jang090623-alt/neo/manual_v2/REPORT.md

# 유성기어 시험기 조립 설명서 2차 — 확인 결과

## 결과물
| 파일 | 내용 |
|---|---|
| `manual.pdf` | 인쇄용 23쪽 (0 부품 전체, 1~21 단계, 22 그림 안내) |
| `pages/page00~22.png` | 쪽 이미지 1400×1000 |
| `bracket_in.stl` | 입력측 센서 받침 수정판 (닫힌 솔리드, 열린 모서리 0, 부피 2655.5 mm³) |
| `src/det.scad` | 수정한 3D 장면 (원본은 `src/det_v1_orig.scad`) |
| `src/compose_pages_v2.py` | 쪽 합성 코드 |
| `src/chk_brk.scad`, `chk2.scad`, `coll.scad`, `coll_b.scad` | 겹침 검사 장면 |

## 1. bracket 겹침 (OpenSCAD intersection → STL 부피 계산)
| 대상 | 겹침 부피 | 범위 |
|---|---|---|
| 원본 bracket ↔ plate_in (입력측) | **468.7 mm³** | x −9.0~−5.2, y −4.8~24.0, z 32.0~62.0 |
| bracket_in ↔ plate_in | **0** (결과 비어 있음) | 끝벽 안쪽 면과 0.2 mm 틈 그대로 |
| bracket_in ↔ ring | 0 | |
| bracket_in ↔ tray | 0 mm³ (윗면 z=32에서 면 접촉만) | |
| 출력측 bracket ↔ plate_out | 0 | |
| 출력측 bracket ↔ ring | 0 | |
| 출력측 bracket ↔ tray | 0 mm³ (면 접촉만) | |

## 2. 추가로 찾은 문제
| # | 내용 | 수치 | 처리 |
|---|---|---|---|
| A | 아래 볼트 2개 머리가 트레이 입력측 끝벽을 파고듦 | 131.5 mm³, x −12.0~−9.2 (2.8 mm) | 사용자가 해결함(방법 미확인). 그림은 설계 그대로 |
| B | det.scad의 bracket 위치 y=9에서는 바닥 긴 구멍이 끝벽 나사 구멍(y=+12)에 못 미침 | M3 나사 몸체와 8.7 mm³ 겹침 | 장면만 y=10으로 옮김 → 0 |
| C | det.scad의 자석이 원판 홈이 아닌 몸체 속에 있었음 | 168.6 mm³ (자석 2개 전체) | 원판을 돌려 홈 위치에 맞춤 → 0 |
| D | 홀센서~원판 간격이 1.75 mm (README는 2~3 mm) | | 2.5 mm로 둠 |
| E | 커플링 구멍 없음, 케이블타이가 받침을 관통, 홀센서 다리가 브래킷과 겹침 | 507 / 805.5 / 0.1 mm³ | 단순 모양을 고쳐 모두 0 |
| F | 모터 받침 나사가 위로 솟고 레일 구멍과 어긋남, 받침당 2개면 총 6개 (README 4개) | | README 수량대로 받침 1·브래킷 1, 실제 구멍(−80.2, 113.4 mm)에 |
| G | 커플링을 끼운 뒤에는 자석 원판(Ø6 구멍)을 막대에 끼울 수 없음 (README 9→10 순서도 같음) | | 원판 15단계 → 모터 16 → 커플링 17로 순서 변경 |

수정 후 완성 장면 13개 부품 그룹의 모든 짝(78쌍) 검사 결과: 위 A, 나사(Ø3)가 Ø2.5 구멍에 셀프태핑으로 들어가는 부분(15.9·23.8 mm³)만 남고 나머지는 0 또는 면 접촉입니다.

## 3. 쪽별 확인 (렌더링 이미지를 직접 열어 봄)
| 단계 | 확인한 것 | 결과 |
|---|---|---|
| 0 | 부품 수: README 목록과 대조, 색 규칙 | 맞음. 홀센서·온도센서는 README 구매 목록에 없어 하단에 적음 |
| 1 | 베어링 좁은 쪽이 아래, 화살표 아래, 돌기 면 위, 확대(플랜지-홈)·뒤집은 판 | 맞음 / README 1 |
| 2 | 1과 같음, plate_in | 맞음 / README 1 |
| 3 | 막대 끝 = 기어 면(단면), 화살표 아래 | 맞음 / README 2 |
| 4 | hub 육각이 위로 carrier에, 막대 끝 = 육각 끝면(단면), 화살표 위 | 맞음 / README 3 |
| 5 | 점 있는 면이 아래, 화살표가 기어 아래 빈 곳 | 맞음 / README 4 (1차는 화살표가 기어 속에서 시작 → 고침) |
| 6 | ring이 plate_out 위, 돌기-구멍 단면 | 맞음 / README 5 |
| 7 | carrier 판이 planet 아래, 막대가 베어링 쪽 | 맞음 / README 5 |
| 8 | sun 허브가 위, 짧은 막대 위 | 맞음 / README 6 |
| 9 | plate_in 안쪽 면 아래, 베어링이 판과 함께 | 맞음 / README 6 |
| 10 | 볼트 머리가 plate_in 쪽, 화살표 4개 | 맞음 / README 6 (속 기어가 빠져 있던 것 추가) |
| 11 | 뒤집힘(plate_out 위), 너트가 홈 속(단면) | 맞음 / README 6 (빠졌던 입력측 베어링 추가) |
| 12 | 두 회전 화살표가 같은 방향, 300°:75° = 4:1 | 맞음 / README 7 |
| 13 | 부채꼴 창 아래, 긴 막대가 빈 칸 쪽 | 맞음 / README 6·8 |
| 14 | 받침 2개, 나사 아래 방향 | 맞음 / README 9 |
| 15 | 원판이 막대 끝에서 들어옴, 자석 홈, 반대쪽 시점 | 맞음 / README 10 (순서 변경 G) |
| 16 | 모터 축이 기어 상자 쪽, 타이가 통로로(단면) | 맞음 / README 9 |
| 17 | 모터를 밀어 끼우는 화살표, 반대쪽 시점 | 맞음 / README 9 |
| 18 | 입력측 bracket_in, 간격 2.5 mm 표시, 반대쪽 시점 | 맞음 / README 10 (가려진 왼쪽 화살표 제거) |
| 19 | 센서 끝 z=6 < 오일면 z=17 | 맞음 / README 11 |
| 20 | 오일 15 mm, 긴 눈금(15 mm) 위치 | 맞음 / README 12 |
| 21 | 완성, 반대쪽 시점 | 맞음 |
| 22 | 단순화 부품 안내 | 적음 |
| 모든 쪽 | 글자 잘림 | 없음 (글자가 넓으면 자동으로 줄이고, 23쪽 모두 열어 확인) |

## 4. 확인하지 못한 것
- 실제 출력물 조립 전체 (끼움 정도, 기어 회전 저항, 오일 누수)
- 볼트 머리 문제(A)를 사용자가 해결한 방법. 설명서 10·13단계는 설계 그대로 그림
- bracket_in.stl의 실제 출력과 끝벽 고정
- 홀센서를 받침에 붙이는 방법 (설계에 없음)
- 모터·커플링·센서·케이블타이·주사기의 실제 모양 (단순화해 그림)
- 원판(Ø6 압입 구멍)을 막대 끝에서 끝벽 위까지 밀어 넣을 수 있는지 (압입이라 힘들 수 있음)
- 커플링을 끼운 뒤 모터를 밀 때, 케이블타이를 느슨하게 감은 상태로 충분히 밀리는지
