jang090623-alt/neo/report/figs/fig3_flow_time_v3.png

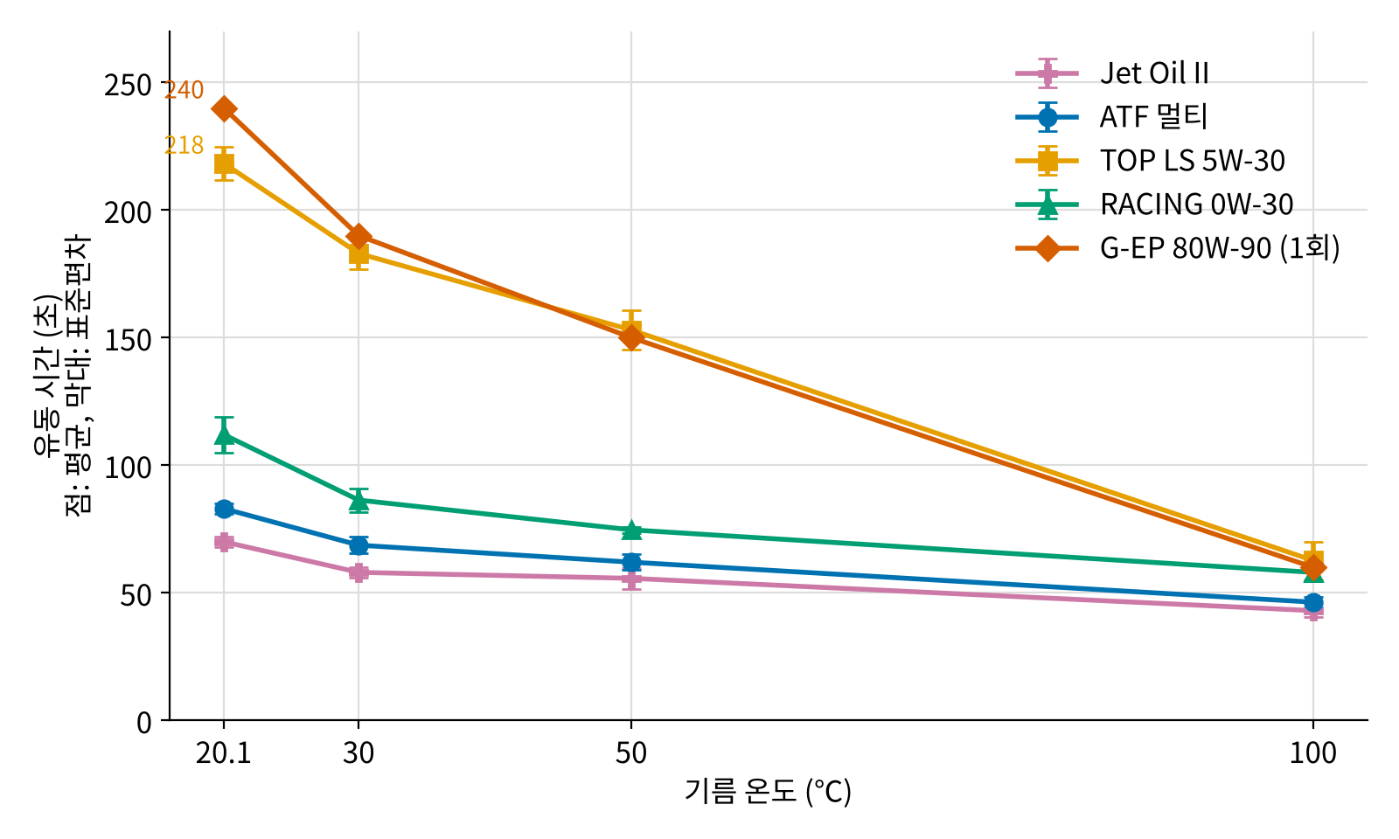
report/figs/fig3_flow_time_v3.png
