jang090623-alt/neo/report/figs/fig4_room_rpm.png

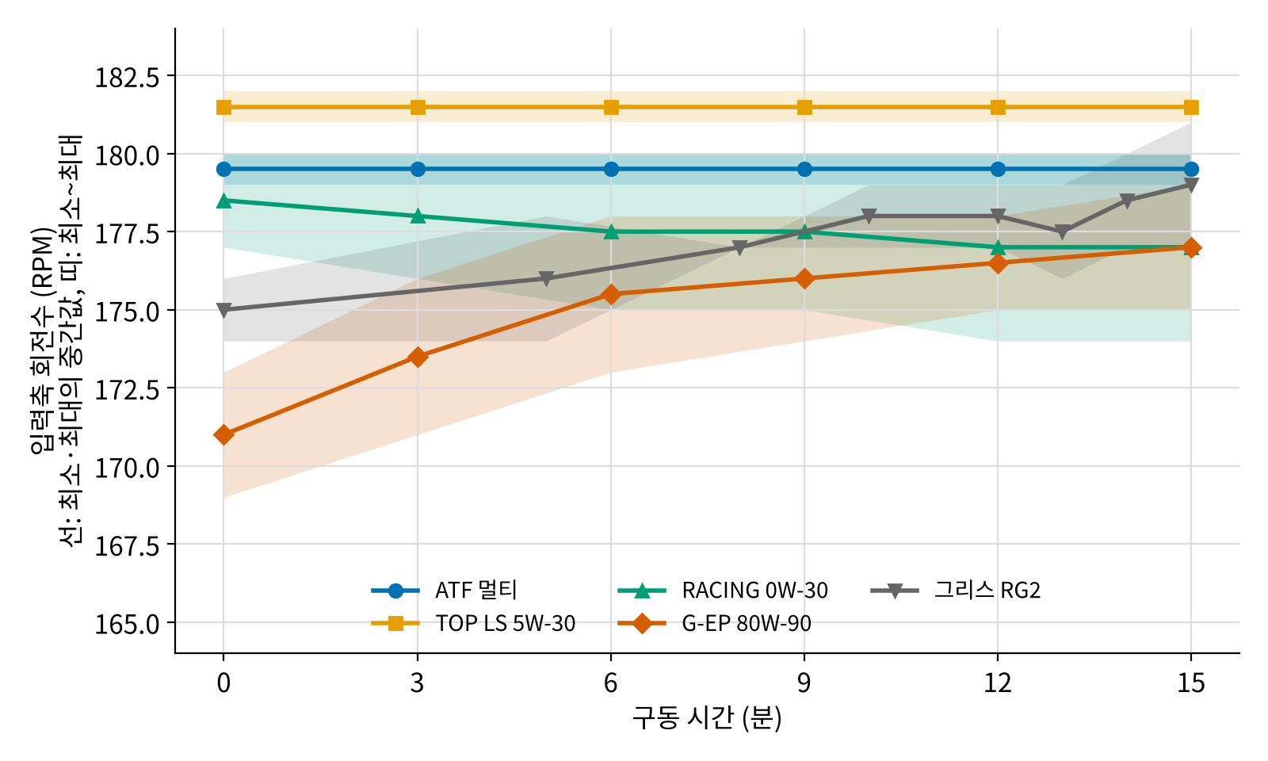
report/figs/fig4_room_rpm.png
