jang090623-alt/neo/report/figs/fig7_efficiency.png

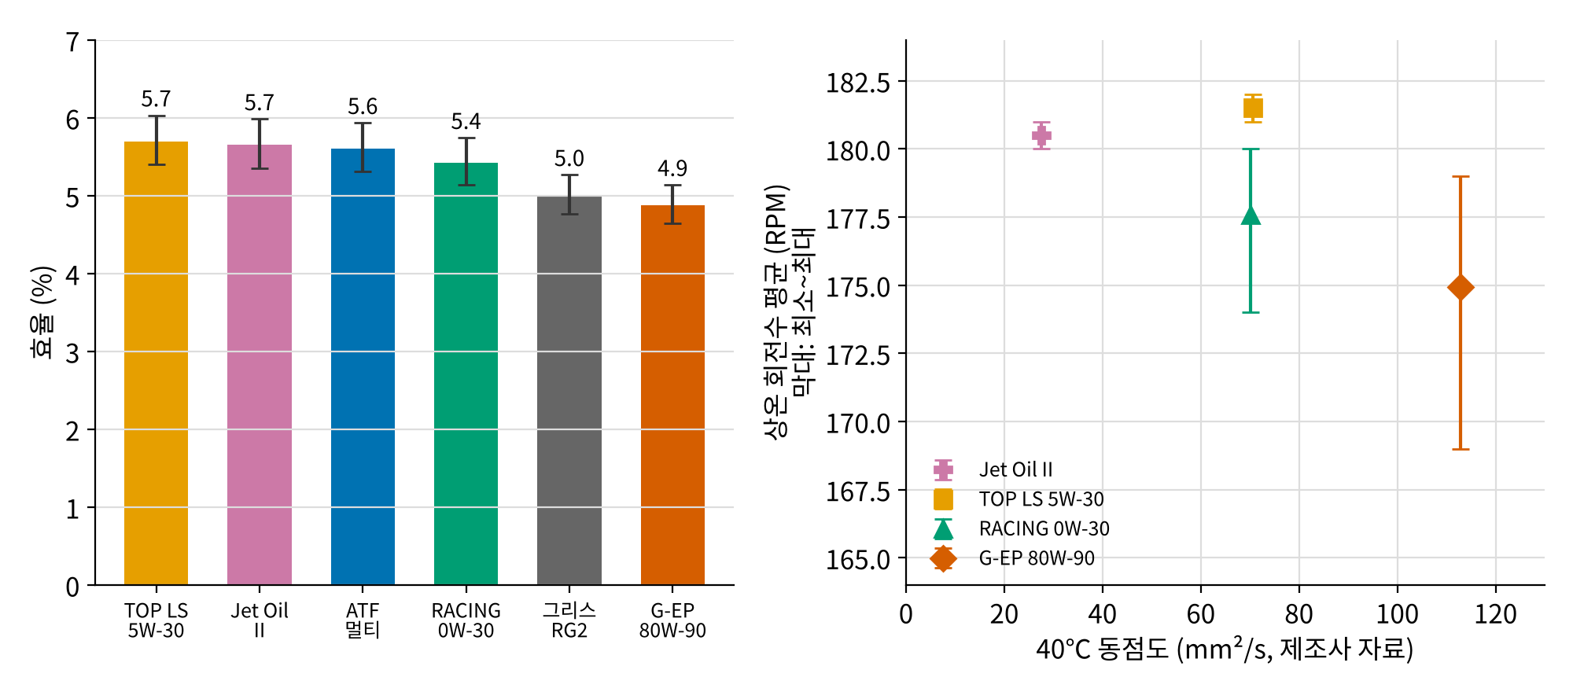
report/figs/fig7_efficiency.png
