jang090623-alt/neo/ball_on_disk/fit_guide.stl

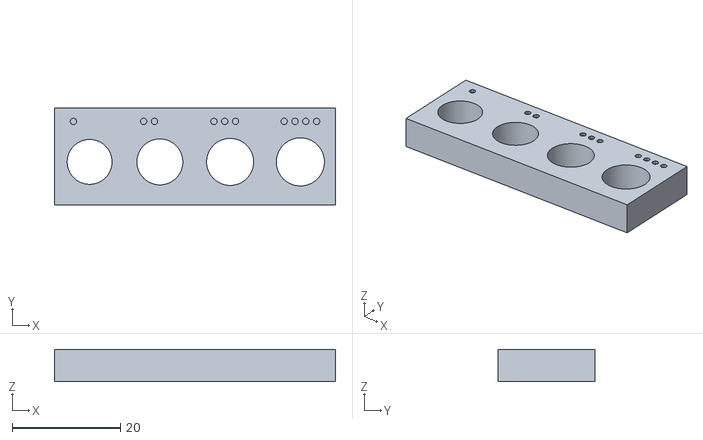
[picture p10: CAD file, 2026-11-05]
ball_on_disk/fit_guide.stl
52.0 x 18.0 x 6.00
