jang090623-alt/neo/ball_on_disk/orig/pin.stl

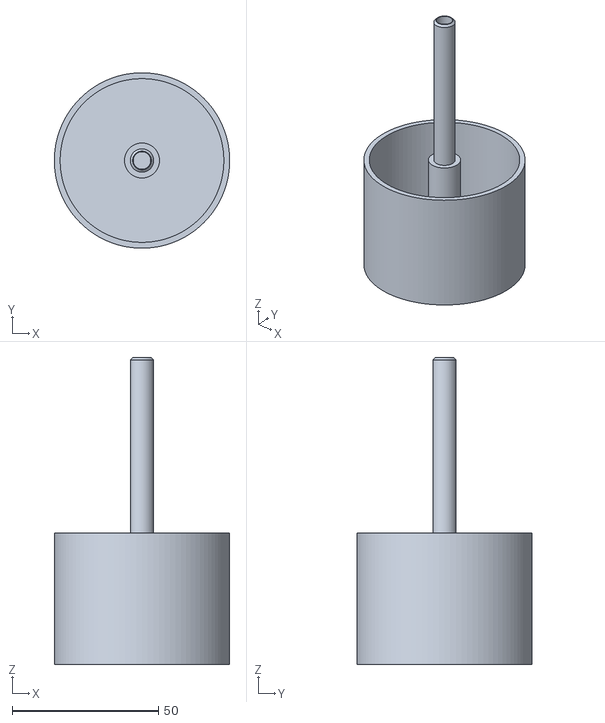
[picture p11: CAD file, 2026-11-05]
ball_on_disk/orig/pin.stl
60.0 x 60.0 x 105.0
