jang090623-alt/neo/manual_v2/bracket_in.stl

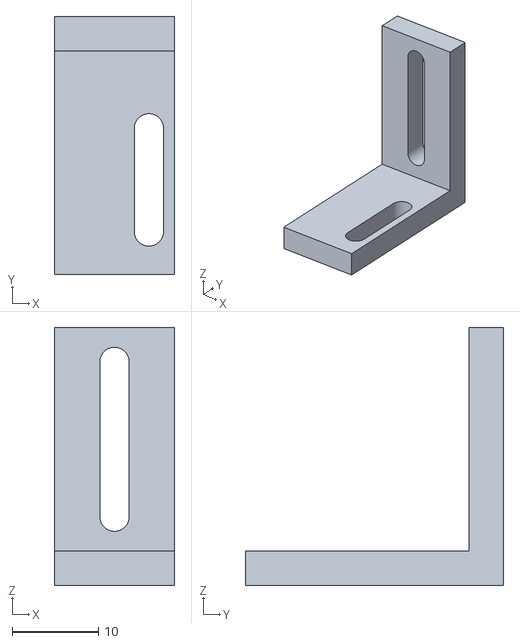
[picture p12: CAD file, 2026-11-05]
manual_v2/bracket_in.stl
14.0 x 30.0 x 30.0
