jang090623-alt/neo/ball_on_disk/orig/arm.stl

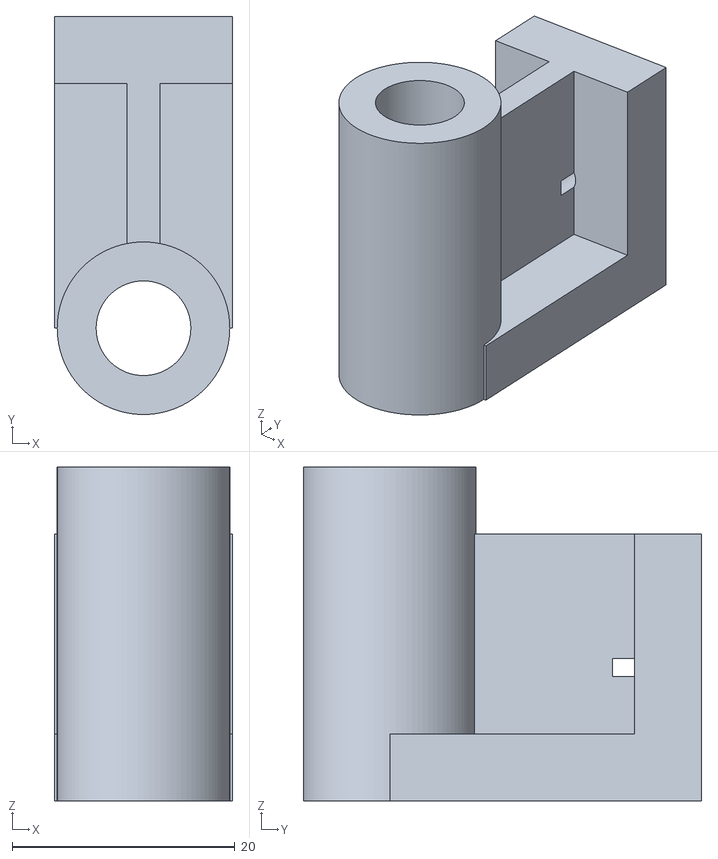
[picture p13: CAD file, 2026-11-05]
ball_on_disk/orig/arm.stl
16.0 x 35.8 x 30.0
