jang090623-alt/neo/ball_on_disk/orig/hub.stl

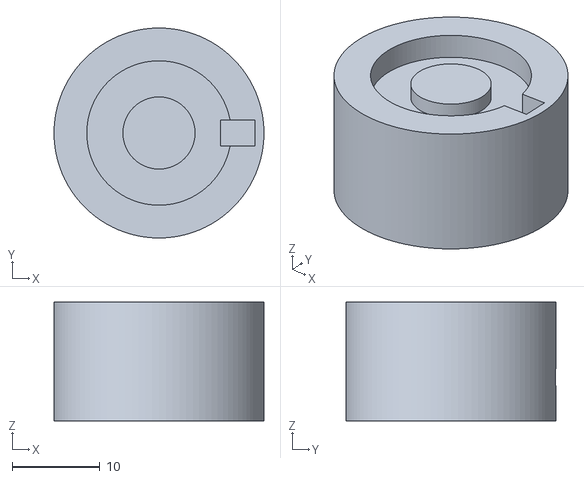
[picture p14: CAD file, 2026-11-05]
ball_on_disk/orig/hub.stl
24.0 x 24.0 x 13.6
