jang090623-alt/neo/manual_v2/src/exp_bi.scad

use <det.scad>
bracket_in();
