jang090623-alt/neo/(list of files, cad)

Other CAD files:
manual_v2/src/det_v1_orig.scad
