jang090623-alt/neo/manual_v2/pages/page00.png

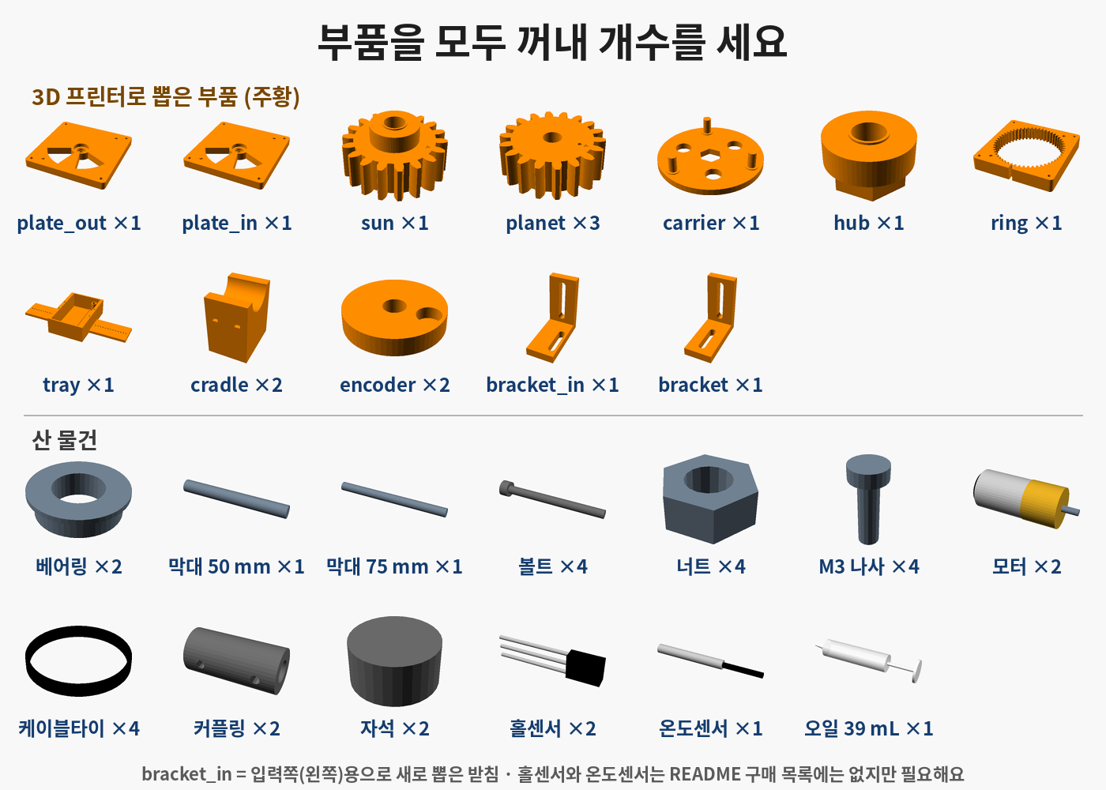
manual_v2/pages/page00.png
