jang090623-alt/neo/manual_v2/pages/page02.png

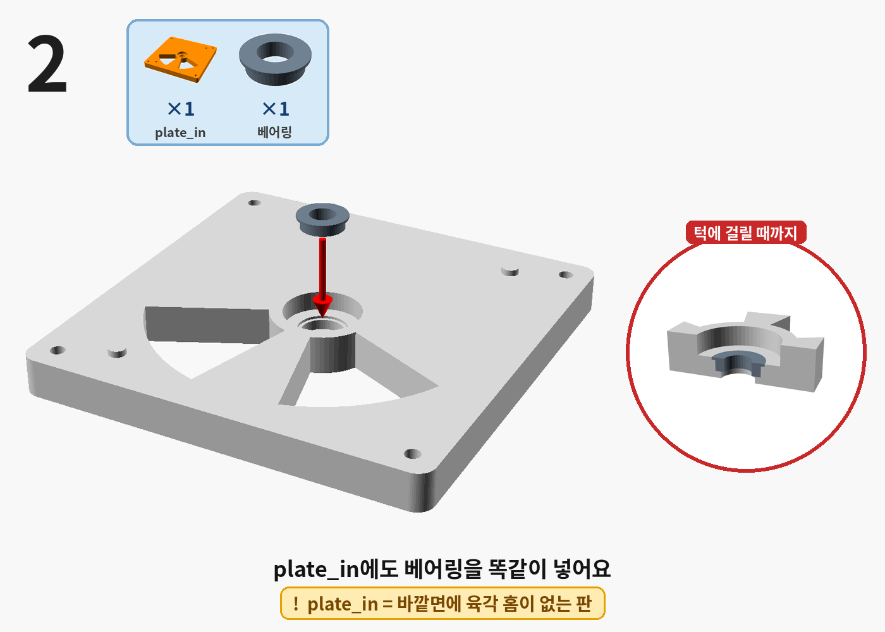
manual_v2/pages/page02.png
