jang090623-alt/neo/manual_v2/pages/page04.png

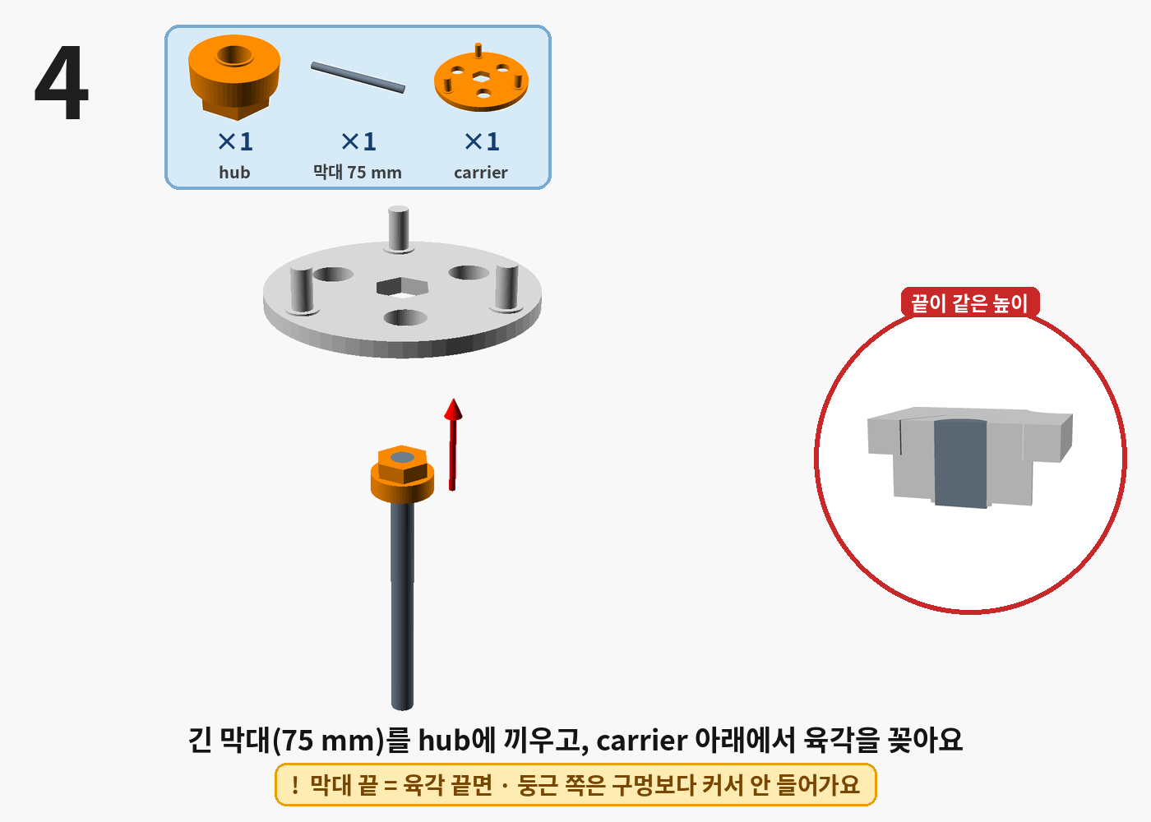
manual_v2/pages/page04.png
