jang090623-alt/neo/experiment/효율_기록시트.xlsx

Sheet: 설명
윤활유 비교 실험 기록 시트
■ 효율이란?
효율(%) = 나온 힘(출력 전력) ÷ 넣은 힘(입력 전력) × 100
입력 전력(W) = 전원 공급기 전압(V) × 전원 공급기 전류(A) ← 전원 공급기 화면에서 읽기
출력 전력(W) = 발전기 전압(V)² ÷ 부하 저항(Ω) ← 왼쪽 모터에 저항을 달고 멀티미터로 전압 재기
■ 방법 A (지금 상태: 왼쪽 모터 선 연결 안 함)
나오는 힘이 0이라 효율(%)은 계산 못 함. 대신 "입력 전력"으로 비교:
같은 전압에서 입력 전력(전류)이 작은 오일 = 마찰로 버리는 힘이 적은 오일
→ 기록 시트에서 부하 저항·발전기 전압 칸은 비워 두기
■ 방법 B (효율 % 까지 재기)
왼쪽 모터의 두 선을 저항(예: 22 Ω, 2 W 이상) 양 끝에 연결 → 멀티미터로 저항 양쪽 전압 측정
이 효율은 "모터 + 기어 + 발전기 모터" 전체 효율이라 기어만의 효율은 아님.
두 모터는 모든 오일에서 같으므로 오일끼리 비교(어느 쪽이 높은지)에는 쓸 수 있음.
■ 칸 색깔
노란 칸 = 직접 입력 (파란 글씨) · 회색 칸 = 자동 계산 (건드리지 않기)
기록 시트 5행은 예시(오일 이름 "예시")라서 비교 시트에 들어가지 않음. 지워도 됨.
■ 기록 방법
실험 1회(30분)마다 0, 5, 10, 15, 20, 25, 30분에 한 줄씩 적기 (오일 1개 = 7줄)
모든 오일에서 같은 조건: 전압 12.0 V · 오일 65 mL · 30분 · (방법 B면) 같은 저항
오일 온도 50 °C 넘으면 바로 정지 (PLA 기어 보호)

Sheet: 기록
측정 기록 (한 줄 = 한 번 읽은 값)
노란 칸만 입력. 부하 저항·발전기 전압은 방법 B일 때만. 회색 칸은 자동 계산.
오일 이름 | 경과 시간 (분) | 전원 전압 (V) | 전원 전류 (A) | 입력축 RPM | 출력축 RPM | 오일 온도 (°C) | 부하 저항 (Ω) [방법 B] | 발전기 전압 (V) [방법 B] | 입력 전력 (W) | 기어비 (4 근처=정상) | 출력 전력 (W) | 효율 (%) | 메모
예시 | 0 | 12.0 | 0.250 | 150.0 | 37.5 | 22.00 | 22 | 2.00 | 3.00 | 4.00 | 0.182 | 6.1% | 예시 줄 (가짜 값) - 지워도 됨

Sheet: 오일 비교
오일별 비교 (자동 계산)
A열에 오일 이름을 기록 시트와 똑같이 입력하면 나머지는 자동으로 채워짐
오일 이름 | 측정 줄 수 | 평균 입력 RPM | 평균 입력 전력 (W) | 시작 온도 (°C) | 최고 온도 (°C) | 온도 상승 (°C) | 평균 기어비 | 평균 효율 (%) [방법 B] | 판단 기준
ATF Multi | 0 |  |  |  | 0.0 |  |  |  | 입력 RPM ↑ · 입력 전력 ↓ · 온도 상승 ↓ · 효율 ↑ = 좋은 오일
 |  |  |  |  |  |  |  |  | 기어비가 4에서 크게 벗어나면 센서 문제 → 그 회차 제외
 |  |  |  |  |  |  |  |  | 모든 오일: 12.0 V · 65 mL · 30분 · 같은 저항
