jang090623-alt/neo/(commit log)

2026-11-05 유성기어 시험기 조립 설명서 2차 (23쪽 PDF) + bracket_in.stl + 확인 보고
    - bracket 겹침 재계산: 원본 468.7 mm3 -> bracket_in 0, 출력측 0
    - det.scad 장면 수정(자석 위치, 브래킷 위치, 커플링·타이·나사 모양), 자석 원판을 커플링보다 먼저
    - 쪽 합성 compose_pages_v2.py, 겹침 검사 장면
    Claude-Session: https://claude.ai/code/session_019q4Liooqet1DkfurNgt54Z
    [bracket_in.stl, chk2.scad, chk_brk.scad, coll.scad, coll_b.scad, det.scad, det_v1_orig.scad, exp_bi.scad]
2026-11-05 윤활유 비교 실험용 아두이노 코드 (PWM 고정, 펄스 간격 회전수, 온도 정지)
    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
2026-11-05 측정 전용 아두이노 코드: 홀센서 2개 RPM·누적 회전수, DS18B20 오일 온도
    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
2026-11-05 실험 기록·효율 계산 시트 (입력 전력, 기어비, 출력 전력, 효율, 오일별 비교)
    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
    [효율_기록시트.xlsx]
2026-11-05 인쇄용 측정 기록지 (회차별 A4 3장 + 오일 비교표)
    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
    [측정_기록지.xlsx]
2026-11-05 기록지에 고정 조건(12.0 V, 65 mL, 30분, 왼쪽 모터 연결 안 함) 미리 채움
    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
    [측정_기록지.xlsx]
2026-11-05 안내관(Ø8) 공차 시험편: fit 의 Ø8.3~8.9 구멍이 서로 붙어 간격을 13 mm 로 넓힘
    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
    [fit_guide.scad, fit_guide.stl]
2026-11-05 시험 4 구멍 수정 파일(fix_holes.scad, fit 번호 입력) + 시험 3 발전기 전압 기록 코드
    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
    [arm.stl, fix_holes.scad, hub.stl, pin.stl]
2026-11-10 실험 최종 정리 문서 (PDF·DOCX): 효율 측정 제외, 이론 예상 효율만 기재
    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
2026-11-11 보고서 자료 추가: 측정 데이터, 분석·그래프 스크립트, 그림 1~6
    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
2026-11-11 파이썬 캐시 폴더를 git 추적에서 제외
    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
2026-11-12 보고서: 항공 터빈오일(Mobil Jet Oil II) 예상값 추가, 그래프 다시 그림
    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
2026-11-12 보고서 최종본(PDF·DOCX) 추가: 항공 터빈오일 반영, 팀원 느낀 점 작성
    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
2026-11-12 보고서: 효율 예상값과 그림 7(효율·동점도-회전수) 추가
    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
2026-11-14 보고서: 경사판 반복 측정값(3회) 반영, 그림 3에 표준편차 표시
    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
2026-11-14 보고서: 기어오일 경사판 3회 측정 반영
    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
